HukoOo/HaagaRobot/3D_printing/holder_right.stl

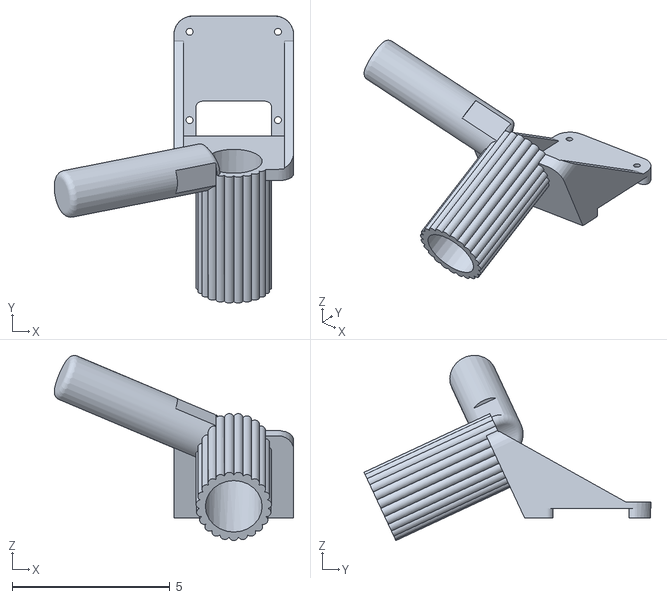
[picture p1: CAD file, 2017-01-05]
3D_printing/holder_right.stl
7.59 x 9.09 x 5.87
