HukoOo/HaagaRobot/3D_printing/rod_25cm.stl

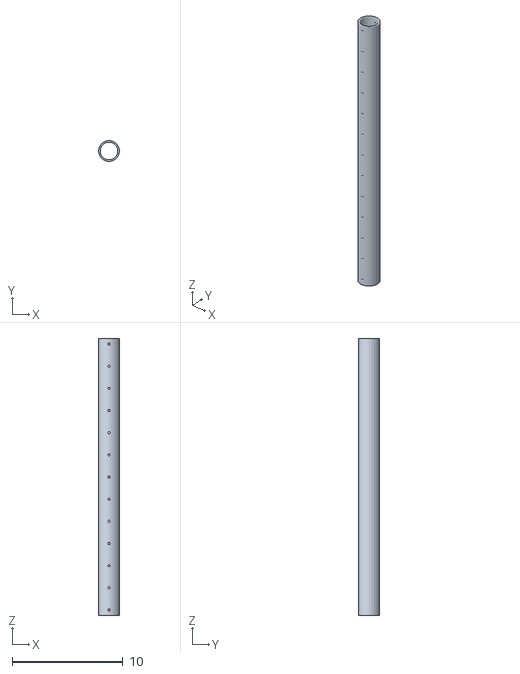
[picture p2: CAD file, 2017-01-05]
3D_printing/rod_25cm.stl
1.88 x 1.88 x 25.0
