HukoOo/HaagaRobot/3D_printing/rod_25cm_center.stl

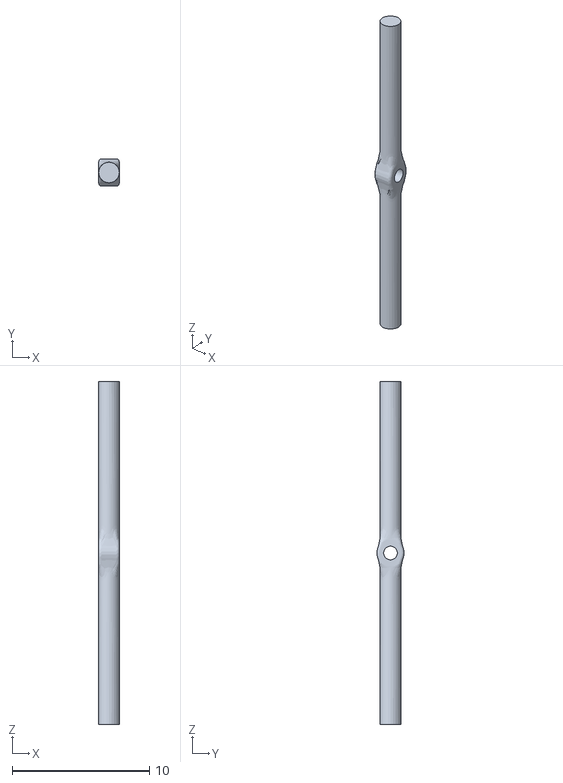
[picture p3: CAD file, 2017-01-05]
3D_printing/rod_25cm_center.stl
1.50 x 1.99 x 25.0
