HukoOo/HaagaRobot/(list of files, cad)

Other CAD files:
3D_printing/holder_left.stl
