HukoOo/HaagaRobot/(commit log)

2016-08-29 modified arduino code for ROS
2017-01-05 add camera jig CAD files
    [holder_left.stl, holder_right.stl, rod_25cm.stl, rod_25cm_center.stl]
